bert/ProgrammableLM317/ProgrammableLM317.kicad_pcb

## KiCad design ProgrammableLM317.kicad_pcb (2015-04-09)

Schematic: ProgrammableLM317.sch

Parts:
C1: 100uF
C2, C6: 10uF
C3, C4, C5, C7, C8, C9: 0.1uF
D1, D2: 1N4001
H1, H2, H3, H4: HOLE
IC1: ATTINY85-P; DIP8
K1: CONN_3
P1, P2, P3: CONN_2
R1: 10k
R2: 33k
R3: 220
R4: 100k
U1: LM317
U2: LM358
U3: MCP4801; DIP8
U4: 7805

Connections:
5V: C4.1, C6.1, C7.1, IC1.8 (VCC), R4.1, U2.5 (+), U3.1 (VDD), U3.6 (~SHDN~), U4.3 (OUT)
GND: C1.2, C2.2, C3.2, C4.2, C5.1, C6.2, C7.2, C8.2, C9.2, IC1.4 (GND), K1.3, P1.2 (PM), P2.2 (PM), P3.1, R1.2, U3.5 (~LDAC~), U3.7 (VSS), U4.2 (GND)
unnamed: IC1.6 (PB1(MISO/DO/AIN1/OC0B/OC1A/PCINT1)), U3.3 (SCK)
unnamed: IC1.7 (PB2(SCK/USCK/SCL/T0/INT0/ADC1/PCINT2)), U3.2 (~CS~)
unnamed: R1.1, R2.2, R4.2, U2.2 (-)
unnamed: D2.1 (A), R2.1, R3.2, U1.1 (ADJ), U2.1
unnamed: U2.6 (-), U2.7
unnamed: IC1.5 (PB0(MOSI/DI/SDA/AIN0/OC0A/OC1A/AREF/PCI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), U3.4 (SDI)
unnamed: U2.3 (+), U3.8 (Vout)
RX: IC1.2 (PB3(XTAL1/CLKI/OC1B/ADC3/PCINT3)), K1.1
TX: IC1.3 (PB4(XTAL2/CLKO/OC1B/ADC2/PCINT4)), K1.2 (PM)
Vcc: C1.1, C3.1, C8.1, D1.2 (K), P1.1, U1.3 (IN), U2.8 (V+), U4.1 (IN)
Vee: C5.2, P3.2 (PM), U2.4 (V-)
Vout: C2.1, C9.1, D1.1 (A), D2.2 (K), P2.1, R3.1, U1.2 (OUT)

Notes on the sheet:
Gain = 4.3
0V to 4.096V in 16mV steps
8-bit DAC in 4.096V mode 1 LSB = 16mV
0V to 17.613V in 69mV steps
1.25V to 18.863V in 69mV steps
RS-232 (TTL)
Safely terminating the unused op amp...

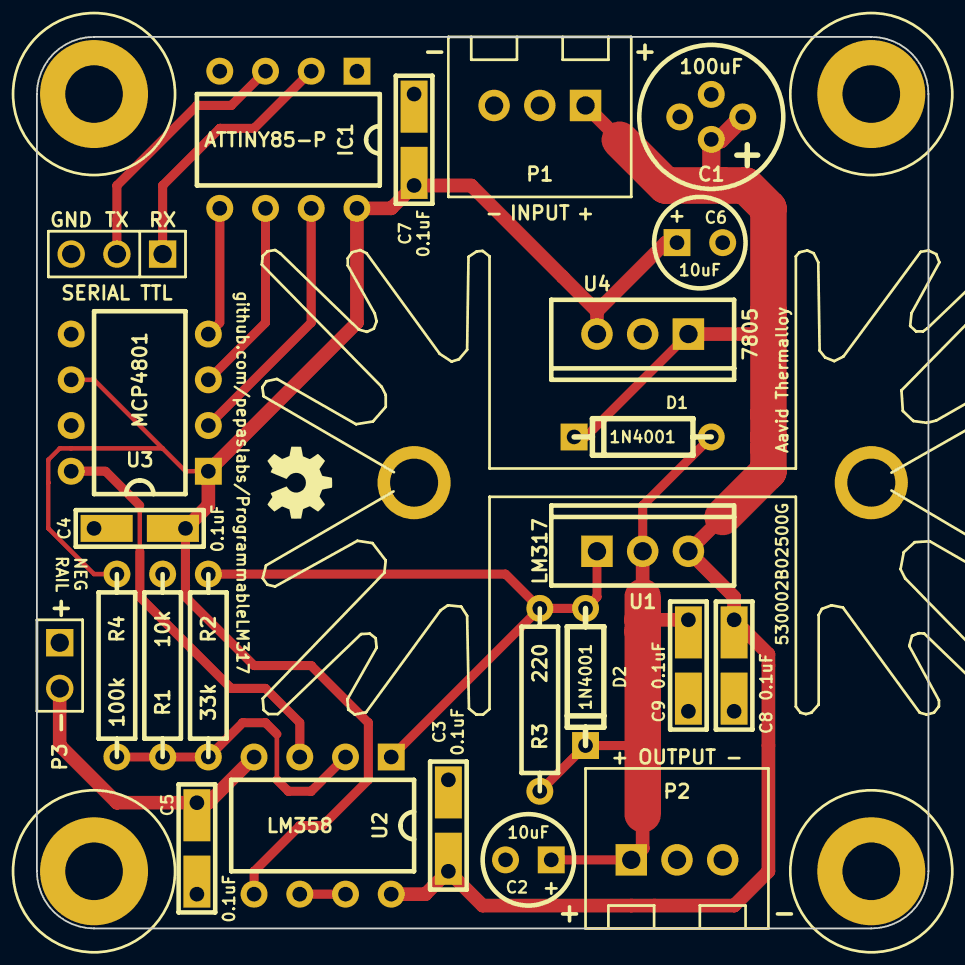
[picture p1: board ProgrammableLM317.kicad_pcb from above]

Board: 2 copper layers, 49.5 x 49.5 mm, 29 parts (0 on the bottom side), 14 nets.

Other parts of the board:
H***: 530002B02500G
