bert/ProgrammableLM317/firmware_tiny85/firmware_tiny85.ino

/*
  firmware_tiny85.ino: Arduino sketch for the Programmable LM317 project.
  See https://github.com/pepaslabs/ProgrammableLM317
  Copyright Jason Pepas (Pepas Labs, LLC)
  Released under the terms of the MIT License.  See http://opensource.org/licenses/MIT
*/

// Hex file compiled using Arduino 1.6.1 for ATtiny85 is 8,164 bytes (of 8,192 max)

#define __STDC_LIMIT_MACROS
#include <stdint.h>

#include "features.h"

#include <SoftwareSerial.h>

#include "buffer.h"
#include "pins.h"
#include "SPI_util.h"
#include "DAC_util.h"
#include "MCP4821.h"

#include "command.h"


// ATtiny85 pinout:
//
//                            +--\/--+
//                       D5  -|1    8|-  Vcc   (to 5V)
//      TTL serial RX    D3  -|2    7|-  D2    SPI CS (to DAC CS, pin 2)
//      TTL serial TX    D4  -|3    6|-  D1    SPI SCK (to DAC SCK, pin 3)
//                      GND  -|4    5|-  D0    SPI MOSI (to DAC SDI, pin 4)
//                            +------+

// MCP4821 pinout:
//
//                            +--\/--+
//             (to 5V)  Vcc  -|1    8|-  Vout
//   (to tiny85 pin 5)  ~CS  -|2    7|-  GND
//   (to tiny85 pin 7)  SCK  -|3    6|-  ~SHDN  (to 5V)
//   (to tiny85 pin 6)  SDI  -|4    5|-  ~LDAC  (to GND)
//                            +------+


/*

Serial commands:

'v': Set the output voltage to 5 volts:

    v5.000;

'c': Set the DAC output code to 37, no gain:

    c37;
    
'C': Set the DAC output code to 217, with 2x gain:

    C217;

'+': Increase the DAC output by one LSB:

    +;

'-': Decrease the DAC output by one LSB:

    -;

(Note: '+' and '-' do not alter the DAC gain bool.)


'g': Calibrate the (op amp) gain:

    g4.3;

'r': Calibrate the LM317 VREF:

    r1.25;

'?': Dump the current state:

    ?;

'd': Disable verbose debug output (default):

    d;

'D': Enable verbose debug output:

    D;

*/


/*

A note about DAC selection and the 'C' command:

The 'c' and 'C' commands are relative to the resolution of the DAC.

To set an MCP4801 (8-bit) DAC to max output voltage:

    C255;

To set an MCP4811 (10-bit) DAC to max output voltage:

    C1023;

To set an MCP4821 (12-bit) DAC to max output voltage:

    C4095;

*/    


// Uncomment one of the following to choose your DAC:
//DAC_config_t dac_config = MCP4801_config();
//DAC_config_t dac_config = MCP4811_config();
DAC_config_t dac_config = MCP4821_config();


// --- DAC / SPI:


DAC_data_t dac_data = { .config = &dac_config, .gain = false, .code = 0x0 };


SPI_bus_t spi_bus = { .MOSI_pin = ATTINY85_PIN_5,
                      .MISO_pin = PIN_NOT_CONNECTED,
                      .SCK_pin = ATTINY85_PIN_6
                    };
                    
SPI_device_t spi_dac = { .bus = &spi_bus,
                         .CS_pin = ATTINY85_PIN_7,
                         .bit_order = MSBFIRST
                       };


// --- Serial interface:


#define RX_pin ATTINY85_PIN_2
#define TX_pin ATTINY85_PIN_3

SoftwareSerial serial(RX_pin, TX_pin);


// --- buffer


#define MIN_EXPECTED_BUFF_LEN 2 // "+;"
#define MAX_EXPECTED_BUFF_LEN 9 // "v12.3456;"
#define BUFF_LEN (MAX_EXPECTED_BUFF_LEN + sizeof('\0'))

char buffer_bytes[BUFF_LEN];
char_buffer_t buffer = { .len = BUFF_LEN, .bytes = buffer_bytes };


// --- globals


// Default values.  These can be calibrated over the serial connection, and are
// remembered via EEPROM.
float LM317_vref = 1.25;
float op_amp_gain = 4.3;


#ifdef HAS_RUNTIME_VERBOSITY_CONFIG
bool verbose = false;
#endif

// ---


void setup()
{
  serial.begin(9600); // 9600 8N1

  #ifdef HAS_BOOT_MESSAGE
  {
    delay(10);
    serial.print("LM317 OK;");
    serial.flush();
  }
  #endif
  
  #ifdef HAS_EEPROM_BACKED_CALIBRATION_VALUES
  {
    bootstrap_EEPROM();
  }
  #endif
  
  // setup soft SPI
  pinMode(spi_bus.MOSI_pin, OUTPUT);
  pinMode(spi_bus.SCK_pin, OUTPUT);
  pinMode(spi_dac.CS_pin, OUTPUT);
  
  digitalWrite(spi_dac.CS_pin, HIGH); // start with the DAC un-selected.

  clear_char_buffer(&buffer);
}


void loop()
{
  command_t command = read_command(&serial, &buffer);
  if (command >= END_OF_COMMANDS_SECTION)
  {
    #ifdef HAS_ERROR_PRINTING
    {
      printError(command);
    }
    #endif
    
    return;
  }

  error_t error;
  
  switch(command)
  {
    
    #ifdef HAS_INCREMENT_COMMAND
    case COMMAND_INCREMENT:
    {
      error = increment_output_voltage(&dac_data, &spi_dac);
      break;
    }
    #endif
  
    #ifdef HAS_DECREMENT_COMMAND
    case COMMAND_DECREMENT:
    {
      error = decrement_output_voltage(&dac_data, &spi_dac);
      break;
    }
    #endif
  
    #ifdef HAS_VOLTS_COMMAND
    case COMMAND_SET_VOLTS:
    {
      error = parse_and_run_voltage_command(&buffer, &dac_data, &spi_dac);
      break;
    }
    #endif
  
    #ifdef HAS_CODE_COMMAND
    case COMMAND_SET_CODE:
    {
      error = parse_and_run_code_command(&buffer, &dac_data, &spi_dac, false);
      break;
    }
    case COMMAND_SET_CODE_W_GAIN:
    {
      error = parse_and_run_code_command(&buffer, &dac_data, &spi_dac, true);
      break;
    }
    #endif

    #ifdef HAS_CALIBRATE_OP_AMP_GAIN_COMMAND
    case COMMAND_CALIBRATE_OP_AMP_GAIN:
    {
      error = parse_and_run_calibrate_gain_command(&buffer, &dac_data, &spi_dac);
      break;
    }
    #endif
  
    #ifdef HAS_CALIBRATE_LM317_VREF_COMMAND
    case COMMAND_CALIBRATE_LM317_VREF:
    {
      error = parse_and_run_calibrate_vref_command(&buffer, &dac_data, &spi_dac);
      break;
    }
    #endif
  
    #ifdef HAS_DUMP_COMMAND
    case COMMAND_DUMP:
    {
      error = dump(&dac_data);
      break;
    }
    #endif

    #ifdef HAS_RUNTIME_VERBOSITY_CONFIG
    case COMMAND_DISABLE_VERBOSE_DEBUG_OUTPUT:
    {
      verbose = false;
      error = OK_NO_ERROR;
      break;
    }
    case COMMAND_ENABLE_VERBOSE_DEBUG_OUTPUT:
    {
      verbose = true;
      error = OK_NO_ERROR;
      break;
    }
    #endif
    
    default:
    {
      error = ERROR_UNKNOWN_COMMAND;
      break;
    }
  }
  
  if (error != OK_NO_ERROR)
  {
    #ifdef HAS_ERROR_PRINTING
    {
      printError(error);
    }
    #endif
    
    return;
  }
  
  #ifdef HAS_SUCCESS_PRINTING
  {
    printSuccess(command);
  }
  #endif
}


// --- EEPROM


#ifdef HAS_EEPROM_BACKED_CALIBRATION_VALUES

uint8_t EEMEM eeprom_has_been_initialized_token_address;
#define EEPROM_HAS_BEEN_INITIALIZED_CODE 42

float EEMEM LM317_vref_EEPROM_address;

float EEMEM op_amp_gain_EEPROM_address;


bool eeprom_has_been_initialized()
{
  uint8_t has_been_initialized_token = eeprom_read_byte(&eeprom_has_been_initialized_token_address);
  return (has_been_initialized_token == EEPROM_HAS_BEEN_INITIALIZED_CODE);
}


void initialize_eeprom()
{
  eeprom_write_byte(&eeprom_has_been_initialized_token_address, EEPROM_HAS_BEEN_INITIALIZED_CODE);
  eeprom_write_float(&LM317_vref_EEPROM_address, LM317_vref);  
  eeprom_write_float(&op_amp_gain_EEPROM_address, op_amp_gain);
}


void load_values_from_eeprom()
{
  LM317_vref = eeprom_read_float(&LM317_vref_EEPROM_address);
  op_amp_gain = eeprom_read_float(&op_amp_gain_EEPROM_address);
}


void bootstrap_EEPROM()
{
  if (eeprom_has_been_initialized() == false)
  {
    initialize_eeprom();
  }
  else
  {
    load_values_from_eeprom();
  }
}

#endif // HAS_EEPROM_BACKED_CALIBRATION_VALUES


// ---


command_t read_command(SoftwareSerial *serial, char_buffer_t *buffer)
{
  // --- read the first character
  
  while(serial->available() == 0)
  {
    continue;
  }
    
  char ch = serial->read();

  error_t error = read_until_sentinel(serial, buffer, ';');
  if (error != OK_NO_ERROR)
  {
    return error;
  }
  
  switch(ch)
  {
    #ifdef HAS_INCREMENT_COMMAND
    case '+':
    {
      return COMMAND_INCREMENT;
    }
    #endif
    
    #ifdef HAS_DECREMENT_COMMAND
    case '-':
    {
      return COMMAND_DECREMENT;
    }
    #endif
    
    #ifdef HAS_VOLTS_COMMAND
    case 'v':
    {
      return COMMAND_SET_VOLTS;
    }
    #endif
    
    #ifdef HAS_CODE_COMMAND
    case 'c':
    {
      return COMMAND_SET_CODE;
    }
    case 'C':
    {
      return COMMAND_SET_CODE_W_GAIN;
    }
    #endif
    
    #ifdef HAS_CALIBRATE_OP_AMP_GAIN_COMMAND
    case 'g':
    {
      return COMMAND_CALIBRATE_OP_AMP_GAIN;
    }
    #endif
    
    #ifdef HAS_CALIBRATE_LM317_VREF_COMMAND
    case 'r':
    {
      return COMMAND_CALIBRATE_LM317_VREF;
    }
    #endif
    
    #ifdef HAS_DUMP_COMMAND
    case '?':
    {
      return COMMAND_DUMP;
    }
    #endif

    #ifdef HAS_RUNTIME_VERBOSITY_CONFIG
    case 'd':
    {
      return COMMAND_DISABLE_VERBOSE_DEBUG_OUTPUT;
    }
    case 'D':
    {
      return COMMAND_ENABLE_VERBOSE_DEBUG_OUTPUT;
    }
    #endif

    default:
    {
      return ERROR_UNKNOWN_COMMAND;
    }
  }
}


error_t read_until_sentinel(SoftwareSerial *serial, char_buffer_t *buffer, char sentinel)
{
  uint8_t num_chars_consumed = 0;
  char *buff_ptr = buffer->bytes;
  
  while(true)
  {
    while(serial->available() == 0)
    {
      continue;
    }
    
    *buff_ptr = serial->read();
    num_chars_consumed++;

    if (*buff_ptr == sentinel)
    {
      *buff_ptr = '\0';
      return OK_NO_ERROR;
    }
    else if (num_chars_consumed == buffer->len - 1)
    {
      *buff_ptr = '\0';
      return ERROR_BUFFER_FILLED_UP_BEFORE_SENTINEL_REACHED;
    }
    else
    {
      buff_ptr++;
      continue;
    }  
  }
}


void send_dac_data(DAC_data_t *dac_data, SPI_device_t *spi_dac)
{
  MCP4821_packet_t packet = dac_data_as_MCP4821_packet(dac_data);
  spi_write_MCP4821_packet(spi_dac, packet);
}


#ifdef HAS_INCREMENT_COMMAND
error_t increment_output_voltage(DAC_data_t *dac_data, SPI_device_t *spi_dac)
{
  if (dac_data_increment_code(dac_data) == false)
  {
    return ERROR_INCREMENT_WOULD_CAUSE_OVERFLOW;
  }

  send_dac_data(dac_data, spi_dac);
  return OK_NO_ERROR;
}
#endif


#ifdef HAS_DECREMENT_COMMAND
error_t decrement_output_voltage(DAC_data_t *dac_data, SPI_device_t *spi_dac)
{
  if (dac_data_decrement_code(dac_data) == false)
  {
    return ERROR_DECREMENT_WOULD_CAUSE_UNDERFLOW;
  }

  send_dac_data(dac_data, spi_dac);
  return OK_NO_ERROR;
}
#endif


#ifdef HAS_VOLTS_COMMAND
error_t parse_and_run_voltage_command(char_buffer_t *buffer, DAC_data_t *dac_data, SPI_device_t *spi_dac)
{
  float output_volts = atof(buffer->bytes);

  #ifdef HAS_RUNTIME_VERBOSITY_CONFIG  
  #ifdef HAS_VOLTS_COMMAND_DEBUGGING
  if (verbose == true)
  {
    serial.println();
    serial.print("parsed volts: ");
    serial.println(output_volts, 4);
    serial.flush();
  }
  #endif
  #endif

  if (output_volts < 0)
  {
    return ERROR_PARSED_VOLTAGE_OUTSIDE_SUPPORTED_RANGE;
  }
  
  float DAC_volts = (output_volts - LM317_vref) / op_amp_gain;
    
  if (dac_data_set_voltage(dac_data, DAC_volts) == false)
  {
    return ERROR_PARSED_VOLTAGE_OUTSIDE_SUPPORTED_RANGE;
  }
  
  MCP4821_packet_t packet = dac_data_as_MCP4821_packet(dac_data);
  spi_write_MCP4821_packet(spi_dac, packet);
  
  return OK_NO_ERROR;
}
#endif


#ifdef HAS_CODE_COMMAND
error_t parse_and_run_code_command(char_buffer_t *buffer, DAC_data_t *dac_data, SPI_device_t *spi_dac, bool use_gain)
{
  uint16_t new_code = atoi(buffer->bytes);

  #ifdef HAS_RUNTIME_VERBOSITY_CONFIG  
  #ifdef HAS_CODE_COMMAND_DEBUGGING
  if (verbose == true)
  {
    serial.println();
    serial.print("parsed code: ");
    serial.println(new_code);
    serial.flush();
  }
  #endif
  #endif

  if (dac_data_set_code(dac_data, new_code) == false)
  {
    return ERROR_PARSED_CODE_OUTSIDE_SUPPORTED_RANGE;
  }
  
  dac_data->gain = use_gain;
  
  send_dac_data(dac_data, spi_dac);
  return OK_NO_ERROR;
}
#endif


#ifdef HAS_CALIBRATE_OP_AMP_GAIN_COMMAND
error_t parse_and_run_calibrate_gain_command(char_buffer_t *buffer, DAC_data_t *dac_data, SPI_device_t *spi_dac)
{
  float new_gain = atof(buffer->bytes);
  
  #ifdef HAS_RUNTIME_VERBOSITY_CONFIG  
  #ifdef HAS_CALIBRATE_OP_AMP_GAIN_COMMAND_DEBUGGING
  if (verbose == true)
  {
    serial.println();
    serial.print("parsed gain: ");
    serial.println(new_gain, 4);
    serial.flush();
  }
  #endif
  #endif
  
  if (new_gain < 1.0)
  {
    return ERROR_PARSED_GAIN_OUTSIDE_SUPPORTED_RANGE;
  }
  
  op_amp_gain = new_gain;
  
  #ifdef HAS_EEPROM_BACKED_CALIBRATION_VALUES
  {
    eeprom_write_float(&op_amp_gain_EEPROM_address, op_amp_gain);
  }
  #endif
  
  return OK_NO_ERROR;  
}
#endif


#ifdef HAS_CALIBRATE_LM317_VREF_COMMAND
error_t parse_and_run_calibrate_vref_command(char_buffer_t *buffer, DAC_data_t *dac_data, SPI_device_t *spi_dac)
{
  float new_vref = atof(buffer->bytes);
  
  #ifdef HAS_RUNTIME_VERBOSITY_CONFIG  
  #ifdef HAS_CALIBRATE_LM317_VREF_COMMAND_DEBUGGING
  if (verbose == true)
  {
    serial.println();
    serial.print("parsed vref: ");
    serial.println(new_vref, 4);
    serial.flush();
  }
  #endif
  #endif
  
  if (new_vref < 0)
  {
    return ERROR_PARSED_VREF_OUTSIDE_SUPPORTED_RANGE;
  }
  
  LM317_vref = new_vref;
  
  #ifdef HAS_EEPROM_BACKED_CALIBRATION_VALUES
  {
    eeprom_write_float(&LM317_vref_EEPROM_address, LM317_vref);  
  }
  #endif
  
  return OK_NO_ERROR;  
}
#endif


#ifdef HAS_ERROR_PRINTING
void printError(error_t error)
{
  serial.print("!e");
  serial.print(error);
  serial.print(";");
  serial.flush();
}
#endif


#ifdef HAS_SUCCESS_PRINTING
void printSuccess(command_t command)
{
  serial.print("ok");
  serial.print(command);
  serial.print(";");
  serial.flush();
}
#endif


#ifdef HAS_DUMP_COMMAND
error_t dump(DAC_data_t *dac_data)
{
  serial.println();
  serial.print("DAC code: ");
  serial.println(dac_data->code);
  serial.print("DAC gain: ");
  serial.println(dac_data->gain);
  serial.print("LM317 vref: ");
  serial.println(LM317_vref, 4);
  serial.print("op amp gain: ");
  serial.println(op_amp_gain, 4);
  serial.flush();
  return OK_NO_ERROR;
}
#endif
