bert/ProgrammableLM317/(commit log)

2015-04-09 adding connector to supply negative rail to op amp.
    [ProgrammableLM317.kicad_pcb, ProgrammableLM317.sch]
2015-04-09 using multi-footprint for input and output connectors.
    [ProgrammableLM317-B_Cu.gbl, ProgrammableLM317-B_Mask.gbs, ProgrammableLM317-B_SilkS.gbo, ProgrammableLM317-Edge_Cuts.gbr, ProgrammableLM317-F_Cu.gtl, ProgrammableLM317-F_Mask.gts, ProgrammableLM317-F_SilkS.gto, ProgrammableLM317.drl]
2015-04-09 using multi-footprints for ceramic bypass capacitors
    [ProgrammableLM317-B_Cu.gbl, ProgrammableLM317-B_Mask.gbs, ProgrammableLM317-B_SilkS.gbo, ProgrammableLM317-Edge_Cuts.gbr, ProgrammableLM317-F_Cu.gtl, ProgrammableLM317-F_Mask.gts, ProgrammableLM317-F_SilkS.gto, ProgrammableLM317.drl]
